neoxey/neox-compact-40m/Navaneeth_Compact_40M_Calculations_BOM_DE.xlsx

Sheet: Parameter_und_Einheiten
Navaneeth Compact 40M v2.0 – Parameter und Einheiten
Verbindliche Master-Parameter, Herstellerspezifikationen, Einheiten und Unsicherheitskennzeichnung
Parameter-ID | Bezeichnung | Symbol | Wert | Einheit | Quelle / Nachweis | Status / Unsicherheit
PAR-01 | Gesamtlänge Flach-Tropfband | L_tape | 40000.00 | mm | Master-Spezifikation / Allwin Gold | VALIDIERT (Feste Anforderung)
PAR-02 | Liegebreite Flach-Tropfband (flach) | W_tape | 25.00 | mm | Allwin Pipes Erode (Toleranz 24,5..25,5 mm) | VALIDIERT (Messung vor Serie)
PAR-03 | Nominaler Innendurchmesser (aufgeblasen) | D_in_tape | 16.00 | mm | Allwin Gold ISI 16 mm Drip Tape | VALIDIERT (Herstellerangabe)
PAR-04 | Effektive Doppelwandstärke inkl. Emitter | t_eff | 1.50 | mm | Einzelwand 0,7 mm + Emitter 2,2..3,0 mm gemittelt | ANNAHME (Physisch zu prüfen)
PAR-05 | Minimaler trockener Biegeradius Band | R_bend_min | 48.00 | mm | Allwin Gold Spezifikation trocken | VALIDIERT (Grenzwert R >= 48 mm)
PAR-06 | Wickel-Packungsfaktor (4-Spur-Traverse) | eta_pack | 0.70 | - | Konservative Annahme inkl. Emitter-Hohlräumen | ANNAHME (Physisch zu prüfen)
PAR-07 | Anzahl axialer Bandspuren auf Trommel | N_lanes | 4.00 | - | 1 durchgehendes 40m-Band über 4 Spuren à 10m | VALIDIERT (REV-06 Traverse)
PAR-08 | Spurabstand / Übergangsstufe | s_lane | 1.00 | mm | Geometriedefinition X = 6,5 + 26*i | VALIDIERT (CAD-Geometrie)
PAR-09 | Nutzbare Konuslänge Trommel | L_cone | 110.00 | mm | X = 3,0 mm bis X = 113,0 mm | VALIDIERT (CAD-Geometrie)
PAR-10 | Hinterer Trommel-Außenradius (X=3) | R_core_back | 52.00 | mm | Ausgangsgeometrie v1.0 / v2.0 | VALIDIERT (CAD-Geometrie)
PAR-11 | Vorderer Trommel-Außenradius (X=113) | R_core_front | 48.15 | mm | Formel R(113) = 52 - 3,85 (> R_bend_min 48,0!) | VALIDIERT (Konflikt aufgelöst)
PAR-12 | Mittlerer Trommel-Kernradius | R_core_mean |  | mm | Berechnet aus R_core_back und R_core_front | VALIDIERT (Formel)
PAR-13 | Flansch-Außendurchmesser | D_flange | 220.00 | mm | Hinter- und Vorderflansch R = 110,0 mm | VALIDIERT (CAD-Geometrie)
PAR-14 | Spindelmittenhöhe über Boden (Z=0) | Z_c | 150.00 | mm | Bezugsebene Y=0, Z=150 mm | VALIDIERT (CAD-Geometrie)
PAR-15 | Bohrschrauber Spannung (INGCO CIDLI12206) | U_drill | 12.00 | V | INGCO Datenblatt CIDLI12206 (12V Li-Ion) | VALIDIERT (Herstellerdaten)
PAR-16 | Leerlaufdrehzahl 1. Gang (INGCO CIDLI12206) | n_drill_low | 400.00 | rpm | INGCO Datenblatt 0-400 / 0-1500 rpm | VALIDIERT (Herstellerdaten)
PAR-17 | Leerlaufdrehzahl 2. Gang (INGCO CIDLI12206) | n_drill_high | 1500.00 | rpm | INGCO Datenblatt 0-400 / 0-1500 rpm | VALIDIERT (Herstellerdaten)
PAR-18 | Max. Katalog-Drehmoment (INGCO CIDLI12206) | M_drill_max | 20.00 | Nm | INGCO Datenblatt 20 Nm (18+1+1 Stufen) | VALIDIERT (Herstellerdaten)
PAR-19 | Ziel-Wickelzeit Minimum | t_wind_min | 3.00 | min | Feste Anforderung Spezifikation | VALIDIERT (Vorgabe)
PAR-20 | Ziel-Wickelzeit Maximum | t_wind_max | 5.00 | min | Feste Anforderung Spezifikation | VALIDIERT (Vorgabe)
PAR-21 | Nominaler Bandzug beim Aufwickeln (trocken) | F_pull_nom | 35.00 | N | Bodenreibung 40 m Flachband auf trockenem Ackerboden | ANNAHME (Zugwaage-Test nötig)
PAR-22 | Max. Bandzug bei Verhaken (Rutschkupplung) | F_pull_max | 120.00 | N | Begrenzt durch Bohrschrauber-Drehmomentstufe 6 (~8 Nm) | ANNAHME (Prüfstandstest nötig)
PAR-23 | Zielmasse Maschine (ohne Schrauber & Akku) | m_target | 5.00 | kg | Feste Anforderung Spezifikation | VALIDIERT (Erreicht: 3,10 kg)

Sheet: Geometrie
Navaneeth Compact 40M v2.0 – Geometrie
Koordinaten-Audit, Trommelkonus-Verifikation und geometrische Konfliktauflösung (v1.0 vs. v2.0)
Geometrie-ID | Baugruppe / Merkmal | Formel / Referenz | Wert v1.0 | Wert v2.0 (Freigegeben) | Differenz | Einheit | Bewertung / Konfliktauflösung
GEO-01 | Trommelbreite berechnet (4 Spuren à 25 mm) |  | 110.00 |  |  | mm | VALIDIERT (100 mm Band + 3 mm Stufen + 7 mm Rand = 110 mm)
GEO-02 | Trommel-Außenradius hinten (X = 3 mm) | R(3) = 52,00 | 52.00 |  |  | mm | VALIDIERT (Unverändert übernommen)
GEO-03 | Trommel-Außenradius vorne (X = 113 mm) | R(113) = 52,0 - 3,85 | 48.15 |  |  | mm | VALIDIERT (48,15 mm > 48,0 mm min. Biegeradius)
GEO-04 | Radialer Konus-Abfall Delta_R (über 110 mm) |  | 3.85 |  |  | mm | VALIDIERT (Lineare Master-Gleichung maßgebend)
GEO-05 | Realer Konuswinkel alpha aus Delta_R = 3,85 mm |  | 2.00 |  |  | Grad | VALIDIERT (Exakt 2,0045°; 2,0° ist Nominalwert)
GEO-06 | Theoretischer Delta_R bei exakt 2,0000° |  | 3.84 |  |  | mm | VALIDIERT (Abweichung nur 0,0087 mm < Fertigungstoleranz)
GEO-07 | Spindeldurchmesser Lagersitz (Lager 6003 d=17) | ISO 286 Welle k5 | 16.80 | 17.00 |  | mm | KONFLIKT GELÖST (v1.0 hatte 0,2 mm Spiel! v2.0: Ø17,00 k5)
GEO-08 | Hinterflansch-Nabenbohrung (REV-03) | ISO 286 H7/h6 + M6-Querstift | 17.80 | 17.02 |  | mm | KONFLIKT GELÖST (v1.0 hatte 1,0 mm Spiel ohne Mitnehmer)
GEO-09 | Lagergehäuse Lagersitzbohrung (Lager 6003 D=35) | ISO 286 Gehäuse H7 | 35.00 | 35.00 |  | mm | VALIDIERT (Mit Innenschulter Ø31 mm bei X=-74..-34 ergänzt)
GEO-10 | Chassisplatte Spindel-Durchgangsbohrung | Freigang für Welle Ø20 / Nabe | 24.00 | 36.00 |  | mm | KONFLIKT GELÖST (Erweitert auf Ø36 mm für Montagefreigang)
GEO-11 | Führungsarm Wandstärke in X (REV-02) | X = -32..-24 mm | 4.00 | 8.00 |  | mm | VALIDIERT (Verdoppelt für Kragarm-Einspannsteifigkeit)
GEO-12 | Führungsachse Durchmesser an Wurzel / Lager (REV-02) | Schulter Ø16 / Lagersitz Ø15,00 k5 | 8.00 | 15.00 |  | mm | KONFLIKT GELÖST (6002-2RS hat d=15,00 mm Bohrung, Schulter Ø16)
GEO-13 | Führungsrolle Außendurchmesser (fuer 6002-2RS D=32) | Lagersitz Ø32 H7 + 3 mm Wand | 24.00 | 38.00 |  | mm | KONFLIKT GELÖST (v1.0 Ø24 war kleiner als Lager 6002 D=32!)
GEO-14 | Fußplatte Unterkante über Boden Z=0 (REV-05) | Z_footplate_min | 6.00 | 12.00 |  | mm | VALIDIERT (Angehoben auf Z=12 mm; Schrauben in +Z gedreht)
GEO-15 | Minimale Bodenfreiheit aller Befestiger (REV-05) | Z_fastener_min | 1.00 | 12.00 |  | mm | VALIDIERT (Keine überstehenden Muttern an Rahmenunterseite)
GEO-16 | Ventilgriff-Stiel Z-Erstreckung (REV-07) | Z = 28..32 mm (R=4 mm) | 30.00 | 28.00 |  | mm | VALIDIERT (2-mm-Lücke zwischen Rohr Z=28 und Stiel geschlossen)

Sheet: Wickelkapazitaet
Navaneeth Compact 40M v2.0 – Wickelkapazitaet
Nachrechnung der 40-m-Wickelkapazität: Einzelspur-Stapel vs. 4-Spur-Traverse und Sensitivitätsanalyse
Szenario-ID | Wickelmodus (Einzelnes durchgehendes 40m-Band) | Spuren N_eff [-] | Eff. Bandstärke t_eff [mm] | Packungsfaktor eta [-] | Berechneter Rollenradius R_coil [mm] | Rollendurchmesser D_coil [mm] | Radialer Flansch-Freiraum (R_flange=110) [mm]
CAP-01 | v2.0 Auslegung: 4-Spur-Traverse (4 x 10 m, nominal R_core=50,0) | 4
CAP-02 | v2.0 Exakt: 4-Spur-Traverse (mittlerer Konus R_core=50,075) | 4
CAP-03 | Sensitivität: 4-Spur-Traverse mit dichter Packung (eta=0,78, t=1,4) | 4 | 1.40 | 0.78
CAP-04 | Sensitivität: 4-Spur-Traverse Worst-Case (eta=0,62, t=1,65) | 4 | 1.65 | 0.62
CAP-05 | Sensitivität: 3-Spur-Traverse (N=3, falls 1 Spur ungenutzt) | 3 | 1.50 | 0.70
CAP-06 | Gegenprobe: 1-Spur-Einzelstapel OHNE Traverse (N=1, t=1,5, eta=0,70) | 1 | 1.50 | 0.70
CAP-07 | Gegenprobe: 1-Spur-Einzelstapel dünnes Band (N=1, t=1,2, eta=0,80) | 1 | 1.20 | 0.80

Sheet: Drehzahl_und_Zeit
Navaneeth Compact 40M v2.0 – Drehzahl und Zeit
Wickelzeit-, Drehzahl- und Untersetzungsmodell mit wachsendem Wickelradius R(N)
Betriebspunkt-ID | Antriebskonfiguration / Szenario | Spindeldrehzahl n_spindel [rpm] | Gesamtumdrehungen N_ges [-] | Berechnete Wickelzeit t_wind [min] | Bandgeschwindigkeit Start v_min [m/s] | Bandgeschwindigkeit Ende v_max [m/s] | Bewertung (Ziel: 3,0 bis 5,0 min)
RPM-01 | Zielzeit Minimum (t = 3,0 min, mit Getriebe i = 12:1 bei 347 rpm) |  |  |  |  |  | FREIGEGEBEN (Untere Zielgrenze 3,0 min)
RPM-02 | Nominaler Auslegungspunkt (t = 4,0 min, mit Getriebe i = 16:1 bei 347 rpm) |  |  |  |  |  | FREIGEGEBEN (Optimaler Betriebspunkt 4,0 min)
RPM-03 | Zielzeit Maximum (t = 5,0 min, mit Getriebe i = 20:1 bei 347 rpm) |  |  |  |  |  | FREIGEGEBEN (Obere Zielgrenze 5,0 min)
RPM-04 | Direktantrieb 1. Gang Teillast-Trigger (n = 60 rpm ohne Getriebe) | 60.00 |  |  |  |  | WARNUNG (1,45 min – zu schnell für Handführung)
RPM-05 | Direktantrieb 1. Gang Nenndrehzahl unter Last (n = 350 rpm) | 350.00 |  |  |  |  | SPERRPUNKT (0,25 min / 15 s – gefährlicher Peitscheffekt!)
RPM-06 | Direktantrieb 1. Gang Leerlauf (INGCO 400 rpm Vollgas) | 400.00 |  |  |  |  | SPERRPUNKT (0,22 min / 13 s – Untersetzung i=16:1 Pflicht!)
RPM-07 | Direktantrieb 2. Gang Leerlauf (INGCO 1500 rpm Vollgas) | 1500.00 |  |  |  |  | SPERRPUNKT (2. Gang mechanisch/organisatorisch sperren!)

Sheet: Drehmoment_und_Kraefte
Navaneeth Compact 40M v2.0 – Drehmoment und Kraefte
Drehmoment-, Bandzug- und Reaktionskraftberechnungen am Spindelantrieb und Bohrschraubergriff
Lastfall-ID | Bezeichnung / Lastzustand | Bandzug F_pull [N] | Wirksamer Hebelarm R [mm] | Spindelmoment M_spindel [Nm] | Reaktionskraft am Griff F_grip (r=85mm) [N] | Zulässiger Grenzwert | Sicherheitsbewertung
TRQ-01 | Wickelbeginn am Kern (Nennbetrieb trocken) |  |  |  |  | 8,00 Nm (Kupplungsstufe 6) | VALIDIERT (M = 1,82 Nm << 8,0 Nm)
TRQ-02 | Wickelende am Außenradius (Nennbetrieb trocken) |  |  |  |  | 8,00 Nm (Kupplungsstufe 6) | VALIDIERT (M = 3,38 Nm << 8,0 Nm)
TRQ-03 | Wickelende feuchtes/verschmutztes Band (Erhöhte Reibung) | 65.0 |  |  |  | 8,00 Nm (Kupplungsstufe 6) | VALIDIERT (M = 6,28 Nm < 8,0 Nm)
TRQ-04 | Blockier-/Verhakungsfall mit Rutschkupplung (Stufe 6) |  |  |  |  | 12,00 Nm (Kupplung löst aus) | VALIDIERT (M = 11,59 Nm; Bandriss > 280 N verhindert)
TRQ-05 | Maximaler Katalog-Blockierfall INGCO CIDLI12206 (REV-04) |  |  |  |  | 20,00 Nm (Struktur-Auslegungslast) | VALIDIERT (Drehmomentstütze P-21 hält 235,3 N sicher)

Sheet: Welle_und_Lager
Navaneeth Compact 40M v2.0 – Welle und Lager
Festigkeitsnachweis Hauptspindel (REV-03), Kragarm-Führungsachse (REV-02) und SKF-Lagerlebensdauer
Nachweis-ID | Bauteil / Querschnitt | Belastungsgröße | Berechneter Wert | Einheit | Zulässiger Wert (Werkstoff / SKF) | Sicherheitsfaktor SF [-] | Status / Kommentar
SHF-01 | Führungsachse v1.0 (Ø8 mm, L=121 mm, F_max=169,7 N) | Biegespannung sigma_b |  | MPa | 430.00 |  | SPERRPUNKT in v1.0 (SF=1,05; Durchbiegung 2,37 mm!)
SHF-02 | Führungsachse v2.0 Lagersitz (Ø15,00 k5, L=121 mm, REV-02) | Biegespannung sigma_b |  | MPa | 430.00 |  | VALIDIERT in v2.0 (SF=6,94; passt zu 6002-2RS d=15!)
SHF-03 | Führungsachse v2.0 Wurzelschulter (Ø16,0 mm bei X=-24, REV-02) | Biegespannung sigma_b |  | MPa | 430.00 |  | VALIDIERT in v2.0 (SF=8,42; Durchbiegung 0,15 mm)
SHF-04 | Hauptspindel v2.0 am Vorderlager X=-29 (Ø17,00 k5, F=141,6 N, T=20 Nm) | Vergleichsspannung sigma_vM |  | MPa | 430.00 |  | VALIDIERT (Kombinierte Biegung + 20 Nm Torsion)
SHF-05 | Hauptspindel v2.0 Nettoquerschnitt an M6-Querbohrung X=-9 (REV-03) | Vergleichsspannung sigma_vM_net | 74.12 | MPa | 430.00 |  | VALIDIERT (Querschnittsschwächung Ø6 in Ø17 berücksichtigt)
SHF-06 | Querschraube M6x35 FK 8.8 bei X=-9 mm (Zweischnittige Scherung) | Scherspannung tau_shear |  | MPa | 384.00 |  | VALIDIERT (Formschnittige Drehmomentübertragung REV-03)
BRG-01 | Vorderes Hauptlager 6003-2RS (X=-34..-24, SKF C0=3250 N) | Max. Radiallast R_front_max |  | N | 3250.00 |  | VALIDIERT (Statische Tragsicherheit S0 = 8,35)
BRG-02 | Hinteres Hauptlager 6003-2RS (X=-84..-74, SKF C0=3250 N) | Max. Radiallast R_rear_max |  | N | 3250.00 |  | VALIDIERT (Statische Tragsicherheit S0 = 13,12)
BRG-03 | Führungsrollenlager 6002-2RS (2x SKF C0=2850 N, REV-02) | Max. Radiallast pro Lager |  | N | 2850.00 |  | VALIDIERT (Statische Tragsicherheit S0 = 19,76)

Sheet: Rahmen_und_Festigkeit
Navaneeth Compact 40M v2.0 – Rahmen und Festigkeit
Festigkeitsnachweis Führungsarm, Chassisplatte, Drehmomentstütze, Flanschschlitze (REV-01) und Kippsicherheit
Struktur-ID | Bauteil / Nachweisstelle | Lastannahme | Berechnete Größe | Einheit | Zulässiger Grenzwert (EN AW-6061-T6) | Sicherheitsfaktor SF [-] | Bewertung
STR-01 | Verstärkter Führungsarm P-12 (B=28, t=8 mm, Hebel 73 mm, REV-02) | Biegespannung am oberen M5-Loch |  | MPa | 240.00 |  | VALIDIERT (Wandstärke 8 mm reduziert Spannung auf 29,3 MPa)
STR-02 | Flansch-Reststeg an 3 Umreifungsschlitzen (REV-01, t=3 mm) | Biegespannung durch Seitenlast 60 N | 24.80 | MPa | 240.00 |  | VALIDIERT (Außenring R=103..110 mm geschlossen ausgeführt)
STR-03 | Konischer Trommelmantel mit 3 Kanälen (t=2,0 mm, REV-01) | Radiale Wickeldruckspannung | 18.40 | MPa | 240.00 |  | VALIDIERT (Beul- und Biegesicherheit SF > 10)
STR-04 | Haupt-Chassisplatte P-11 (t=4,0 mm EN AW-6061-T6) | Biege-/Lochleibungsspannung M5 | 31.50 | MPa | 240.00 |  | VALIDIERT (4x M5 auf Teilkreis R=28 mm tragen Gehäuse sicher)
STR-05 | Bohrschrauber-Drehmomentstütze P-21 (M_max = 20 Nm, REV-04) | Biegespannung U-Profil (W_b = 600 mm³) |  | MPa | 240.00 |  | VALIDIERT (Reaktionsmoment vollständig im Rahmen abgestützt)
STR-06 | Ventilseitige Zugentlastungsklemme P-22 (F_max = 120 N) | Klemmhalte- & Biegespannung | 16.20 | MPa | 240.00 |  | VALIDIERT (Isoliert 100 % der Bandzugkräfte vom Ventil)
STR-07 | Standsicherheit / Kippsicherheit bei Bandzug F_nom = 35 N (Z=285) | Standmoment vs. Kippmoment (mit Fuß auf P-20) | 38.50 | Nm | 9.98 |  | VALIDIERT (Mit Bedienerfuß auf Fußplatte P-20 SF = 3,86)

Sheet: Massenbudget
Navaneeth Compact 40M v2.0 – Massenbudget
Vollständige materialbasierte Massenbilanz (Ziel <= 5,000 kg ohne Bohrschrauber und Akku)
Bauteil-ID | Bezeichnung | Werkstoff | Dichte [g/cm³] | Volumen pro Stück [cm³] | Anzahl [-] | Einzelmasse [kg] | Gesamtmasse [kg]
P-01 | Hinterer Flansch mit angeschweißter Nabe (REV-01/03) | EN AW-6061-T6 | 2.70 | 121.66 | 1
P-02 | Konische Trommel mit 3 Umreifungskanälen (REV-01) | EN AW-6061-T6 | 2.70 | 95.44 | 1
P-03 | Klett-Umreifungsbänder 15x380 mm | PP/PA Gewebeband | 0.91 | 8.55 | 3
P-04 | Vorderer abnehmbarer Schutzflansch mit Bund (REV-01) | EN AW-6061-T6 | 2.70 | 100.03 | 1
P-05 | Axiale Haltescheibe Ø34/Ø17,2x2 mm | C45E verzinkt | 7.85 | 1.35 | 1
P-06 | Sicherungspin Klappstecker Ø6x30 mm mit Zugring | C45E verzinkt | 7.85 | 1.16 | 1
P-07 | Hauptspindel Ø17,00 k5 mit 3/8"-Antriebszapfen (REV-03) | C45E +QT | 7.85 | 50.37 | 1
P-08 | Rillenkugellager 6003-2RS (17x35x10 mm, SKF Katalog) | 100Cr6 Wälzlagerstahl | 7.81 | 4.99 | 2
P-09 | Abgesetztes Lagergehäuse mit Innenschulter (REV-03) | EN AW-6061-T6 | 2.70 | 53.78 | 1
P-10 | Lager-Distanzhülse Innenring Ø22/Ø17,1x40 mm | EN AW-6061-T6 | 2.70 | 6.03 | 1
P-11 | Haupt-Chassisplatte 150x170x4 mm (mit Erleichterungen) | EN AW-6061-T6 | 2.70 | 82.59 | 1
P-12 | Verstärkter Führungsarm 28x95x8 mm (REV-02) | EN AW-6061-T6 | 2.70 | 20.26 | 1
P-13 | Kragarm-Führungsachse Ø16/Ø15,00 k5 hohlgebohrt (REV-02) | C45E +QT | 7.85 | 22.01 | 1
P-14 | Rillenkugellager 6002-2RS (15x32x9 mm, SKF, REV-02) | 100Cr6 Wälzlagerstahl | 7.81 | 3.84 | 2
P-15 | Band-Führungsrolle Ø38x132 mm (REV-02) | POM-C | 1.41 | 74.68 | 1
P-16 | 4-Spur-Bandführungsschlitten X=19/45/71/97 (REV-06) | POM-C | 1.41 | 15.42 | 1
P-17 | Beinleisten 20x82x4 mm (Links & Rechts) | EN AW-6061-T6 | 2.70 | 6.37 | 2
P-18 | Querträger Hohlprofil 20x20x2,5x240 mm | EN AW-6061-T6 | 2.70 | 42.00 | 1
P-19 | Bodenschienen Hohlprofil 20x20x2,5x240 mm (L & R) | EN AW-6061-T6 | 2.70 | 42.00 | 2
P-20 | Fußplatte mit 4 Antirutsch-Rippen Z=12..18 (REV-05) | EN AW-6061-T6 | 2.70 | 46.59 | 1
P-21 | Bohrschrauber-Drehmomentstütze & Griffklemme (REV-04) | EN AW-6061-T6 | 2.70 | 53.59 | 1
P-22 | Ventilseitige Zugentlastungs- und Parkklemme | EN AW-6061-T6 | 2.70 | 16.41 | 1
P-23A | Vordere Elastomerdämpfer-Standfüße Ø24x28 mm | NBR 70 Shore A | 1.25 | 11.88 | 2
P-23B | Hintere Elastomerdämpfer-Pads Ø24x12 mm (REV-05) | NBR 70 Shore A | 1.25 | 5.09 | 4
FAST | Kompletter Normbefestigersatz (34 Verschraubungen F-01..F-34) | Stahl FK 8.8 verzinkt | 7.85 | 23.04 | 1
SUM-M | GESAMTMASSE MASCHINE (ohne Bohrschrauber, Akku & Tropfband) | Zielwert <= 5,000 kg

Sheet: BOM
Navaneeth Compact 40M v2.0 – BOM
Vollständige Stückliste (Revision 2.0) mit Halbzeugen, Fertigungsverfahren, Passungen, Koordinaten und Zeichnungsreferenz
Teile-ID | Bezeichnung | Menge | Werkstoff / Norm | Fertigungsverfahren | Hauptabmessungen [mm] | Bohrungen / Passungen | XYZ-Einbaulage [mm] | Verbundene Teile / Fastener | Gesamtmasse [kg] | Zeichnungs-Nr.
P-01 | Hinterer Flansch mit Nabe | 1 | EN AW-6061-T6 | Laserschneiden + Drehen + WIG-Schweißen | Ø220x3 + Nabe Ø44/Ø17x18 | Nabe Ø17,02 H7, Querloch Ø6,0 H11, 6x Ø5,5, 3x Schlitz 16x58 | X=[-18..3], Y=0, Z=150 | P-02, P-07 / F-11..16, F-21 |  | DRW-P01-v2
P-02 | Konische Trommel (3 Kanäle) | 1 | EN AW-6061-T6 | Drückwalzen / CNC-Drehen + Fräsen | Ø104/Ø96,3 x 110, Wand 2,0 | 6x Ø5,5 auf TK R=38, 3x Kanal B=16xT=6 | X=[3..113], Y=0, Z=150 | P-01, P-03, P-04 / F-11..16 |  | DRW-P02-v2
P-03 | Klett-Umreifungsband | 3 | PP/PA Gewebe | Kaufteil konfektioniert | 15 x 380 x 1,5 | Rückschnallöse Metall/PA | X=[5..111], 0°/120°/240° | P-02, REF-01 (Bandrolle) |  | DRW-P03-v2
P-04 | Vorderer Schutzflansch | 1 | EN AW-6061-T6 | Laserschneiden + CNC-Zentrierbund | Ø220x3 + Bund Ø30x1 | Zentrierbohrung Ø17,20 H8, 6x Ø18, 3x Schlitz 16x58 | X=[113..117], Y=0, Z=150 | P-02, P-05, P-07 |  | DRW-P04-v2
P-05 | Axiale Haltescheibe | 1 | C45E verzinkt | Drehen / Stanzen DIN 988 | Ø34 / Ø17,2 x 2,0 | Bohrung Ø17,20 (+0,20) | X=[117..119], Y=0, Z=150 | P-04, P-06, P-07 |  | DRW-P05-v2
P-06 | Sicherungspin (Klappstecker) | 1 | Stahl verzinkt | Normkaufteil DIN 11023 | Schaft Ø6,0 x 30, Ring Ø17 | Paarung mit Bohrung Ø6,2 in P-07 | X=122, Y=0, Z=[135..175] | P-05, P-07 |  | DRW-P06-v2
P-07 | Hauptspindel mit 3/8"-Sechskant | 1 | C45E +QT | CNC-Drehen + Fräsen + Schleifen | Ø17,00 k5 x 212 + SW9,5 x 36 | Lagersitz Ø17,00 k5, Schulter Ø20, Querloch Ø6,0 (X=-9), Pinloch Ø6,2 (X=122) | X=[-120..128], Y=0, Z=150 | P-01, P-04..06, P-08, P-10 / F-21 |  | DRW-P07-v2
P-08 | Rillenkugellager 6003-2RS | 2 | 100Cr6 (SKF) | Normkaufteil DIN 625-1 | d=17,00 x D=35,00 x B=10,00 | Innenring auf Ø17 k5, Außenring in Ø35 H7 | X=[-84..-74] & [-34..-24], Z=150 | P-07, P-09, P-10 |  | DRW-P08-v2
P-09 | Abgesetztes Lagergehäuse | 1 | EN AW-6061-T6 | CNC-Drehen + Bohren | Rohr Ø45x56, Flansch Ø68x4 | 2x Lagersitz Ø35,00 H7 (10 tief), Innenschulter Ø31, 4x Ø5,5 auf TK R=28 | X=[-84..-24], Y=0, Z=150 | P-08, P-11 / F-01..04 |  | DRW-P09-v2
P-10 | Lager-Distanzhülse Innenring | 1 | EN AW-6061-T6 | Drehen aus Rohr | Ø22,0 / Ø17,1 x 40,0 | Bohrung Ø17,10 (+0,10), Planlauf 0,02 | X=[-74..-34], Y=0, Z=150 | P-07, P-08A, P-08B |  | DRW-P10-v2
P-11 | Haupt-Chassisplatte | 1 | EN AW-6061-T6 | Laserschneiden + Entgraten | 150 x 170 x 4,0 | Zentral Ø36, 4x Ø5,5 (TK28), 4x Ø5,5 (Beine), 2x Ø5,5 (Arm), 2x Fenster 30x70 | X=[-24..-20], Y=[-75..75], Z=[65..235] | P-09, P-12, P-17 / F-01..10 |  | DRW-P11-v2
P-12 | Verstärkter Führungsarm | 1 | EN AW-6061-T6 | CNC-Fräsen / Wasserstrahl | 28 x 95 x 8,0 | 2x Ø5,5 (Z=212, 228), 1x Ø10,2 (Z=285) | X=[-32..-24], Y=[-14..14], Z=[205..300] | P-11, P-13 / F-09..10, F-22 |  | DRW-P12-v2
P-13 | Kragarm-Führungsachse | 1 | C45E +QT | CNC-Drehen + Tieflochbohren | M10x12 + Ø16x10 + Ø15,00 k5 x 142 | Lagersitz Ø15,00 k5, Hohlbohrung Ø8x120, Gewinde M10x1,5 | X=[-36..128], Y=0, Z=285 | P-12, P-14 / F-22 |  | DRW-P13-v2
P-14 | Rillenkugellager 6002-2RS | 2 | 100Cr6 (SKF) | Normkaufteil DIN 625-1 | d=15,00 x D=32,00 x B=9,00 | Innenring auf Ø15 k5, Außenring in Ø32 H7 | X=[-14..-5] & [109..118], Z=285 | P-13, P-15 |  | DRW-P14-v2
P-15 | Band-Führungsrolle | 1 | POM-C | CNC-Drehen | Ø38,0 / Ø26,0 x 132,0 | 2x Lagersitz Ø32,00 H7 x 9,0 tief | X=[-14..118], Y=0, Z=285 | P-14, P-16 |  | DRW-P15-v2
P-16 | 4-Spur-Bandführungsschlitten | 1 | POM-C | CNC-Fräsen / Drehen | 5x Führungsbund Ø47/Ø38 x 2,0 | Spurzentren X=19, 45, 71, 97 mm (Spurbreite 26 mm) | X=[4,5..110,5], Y=0, Z=285 | P-15, REF-01 |  | DRW-P16-v2
P-17 | Beinleisten (Links & Rechts) | 2 | EN AW-6061-T6 | Laserschneiden + Schweißen an P-18 | 20 x 82 x 4,0 | Je 2x Ø5,5 bei Z=75 und Z=100 mm | X=[-28..-24], Y=±[45..65], Z=[28..110] | P-11, P-18 / F-05..08 |  | DRW-P17-v2
P-18 | Querträger Hohlprofil | 1 | EN AW-6061-T6 | Sägen + Bohren + Senken | 20 x 20 x 2,5 x 240 | 2x Ø6,5 (Y=±95), 2x Ø6,5 (Y=±30), Flachsenkung unten Z=8..12 | X=[-34..-14], Y=[-120..120], Z=[8..28] | P-17, P-19, P-20, P-23B / F-17..20 |  | DRW-P18-v2
P-19 | Bodenschienen Hohlprofil (L&R) | 2 | EN AW-6061-T6 | Sägen + Bohren | 20 x 20 x 2,5 x 240 | Je 1x Ø6,5 (X=-24), 1x Ø5,5 (X=196), 2x Ø5,5 (Zugentlastung) | X=[-34..206], Y=±[85..105], Z=[28..48] | P-18, P-22, P-23A / F-17..18, F-27..30 |  | DRW-P19-v2
P-20 | Fußplatte mit Antirutsch-Rippen | 1 | EN AW-6061-T6 | Fräsen / Strangpressprofil | 140 x 100 x 3,0 + 4 Rippen 4x3 | 2x Ø6,5 (X=-24, Y=±30), 4x Ø5,5 (Drehmomentstütze), 2x Ø5,5 (Pads) | X=[-154..-14], Y=[-50..50], Z=[12..18] | P-18, P-21, P-23B / F-19..20, F-23..26 |  | DRW-P20-v2
P-21 | Bohrschrauber-Drehmomentstütze | 1 | EN AW-6061-T6 + NBR | Abkanten + Fräsen + NBR-Auskleidung | 60 x 60 x 93, Griffaufnahme 45x36 | 4x Ø5,5 Fußflansch, 2x M5 Klemmschraube für Griff | X=[-235..-175], Y=[-30..30], Z=[15..108] | P-20, REF-02 / F-23..26 |  | DRW-P21-v2
P-22 | Ventil-Zugentlastungsklemme | 1 | EN AW-6061-T6 + POM | CNC-Fräsen | 32 x 30 x 36, Bandkanal 26x4 | 2x Ø5,5 Montage an rechter Bodenschiene + Schnellspanner | X=[42..74], Y=[-135..-105], Z=[28..64] | P-19R, REF-03 / F-27..28 |  | DRW-P22-v2
P-23A | Vordere Elastomerdämpfer-Füße | 2 | NBR 70 Shore A | Kaufteil / Formteil | Ø24 / Ø6,0 x 28,0 | Durchgangsbohrung Ø5,5 mit Senkung | X=196, Y=±95, Z=[0..28] | P-19 / F-29..30 |  | DRW-P23-v2
P-23B | Hintere Elastomerdämpfer-Pads | 4 | NBR 70 Shore A | Kaufteil / Formteil | Ø24 / Ø5,5 x 12,0 | Durchgangsbohrung Ø5,5 mit Senkung | X=-24 (Y=±110) & X=-140 (Y=±40), Z=[0..12] | P-18, P-20 / F-31..34 |  | DRW-P23-v2

Sheet: Fastener_Register
Navaneeth Compact 40M v2.0 – Fastener Register
Vollständiges Befestigerregister mit Instanz-ID, Norm, Gewinde, XYZ-Position, Einbaurichtung und Montagezugang
Fastener-ID | Norm & Gewinde | Abmessung & Kopfform | Scheiben & Mutter | Werkstoff / Klasse | XYZ-Mittelpunkt [mm] | Achs- & Einbaurichtung | Verbundene Bauteile | Montagezugang / Werkzeug | Richt-Anziehdrehmoment [Nm]
F-01 | ISO 4017 M5x16 | M5 x 16, Sechskant SW8 | 2x ISO 7089 A5,3 + 1x ISO 10511 M5 | Stahl FK 8.8 verzinkt | X=-28..-16, Y=+19,8, Z=169,8 (45°) | +X (Kopf bei X=-28, Mutter X=-20) | P-09 (Lagergehäuse) + P-11 (Chassis) | SW8 Steckschlüssel beidseitig frei | 5.5
F-02 | ISO 4017 M5x16 | M5 x 16, Sechskant SW8 | 2x ISO 7089 A5,3 + 1x ISO 10511 M5 | Stahl FK 8.8 verzinkt | X=-28..-16, Y=-19,8, Z=169,8 (135°) | +X (Kopf bei X=-28, Mutter X=-20) | P-09 (Lagergehäuse) + P-11 (Chassis) | SW8 Steckschlüssel beidseitig frei | 5.5
F-03 | ISO 4017 M5x16 | M5 x 16, Sechskant SW8 | 2x ISO 7089 A5,3 + 1x ISO 10511 M5 | Stahl FK 8.8 verzinkt | X=-28..-16, Y=-19,8, Z=130,2 (225°) | +X (Kopf bei X=-28, Mutter X=-20) | P-09 (Lagergehäuse) + P-11 (Chassis) | SW8 Steckschlüssel beidseitig frei | 5.5
F-04 | ISO 4017 M5x16 | M5 x 16, Sechskant SW8 | 2x ISO 7089 A5,3 + 1x ISO 10511 M5 | Stahl FK 8.8 verzinkt | X=-28..-16, Y=+19,8, Z=130,2 (315°) | +X (Kopf bei X=-28, Mutter X=-20) | P-09 (Lagergehäuse) + P-11 (Chassis) | SW8 Steckschlüssel beidseitig frei | 5.5
F-05 | ISO 4017 M5x16 | M5 x 16, Sechskant SW8 | 2x ISO 7089 A5,3 + 1x ISO 10511 M5 | Stahl FK 8.8 verzinkt | X=-28..-16, Y=+55,0, Z=75,0 | +X (Kopf bei X=-28, Mutter X=-20) | P-17L (Bein links) + P-11 (Chassis) | SW8 Gabel-/Ringmaulschlüssel frei | 5.5
F-06 | ISO 4017 M5x16 | M5 x 16, Sechskant SW8 | 2x ISO 7089 A5,3 + 1x ISO 10511 M5 | Stahl FK 8.8 verzinkt | X=-28..-16, Y=+55,0, Z=100,0 | +X (Kopf bei X=-28, Mutter X=-20) | P-17L (Bein links) + P-11 (Chassis) | SW8 Gabel-/Ringmaulschlüssel frei | 5.5
F-07 | ISO 4017 M5x16 | M5 x 16, Sechskant SW8 | 2x ISO 7089 A5,3 + 1x ISO 10511 M5 | Stahl FK 8.8 verzinkt | X=-28..-16, Y=-55,0, Z=75,0 | +X (Kopf bei X=-28, Mutter X=-20) | P-17R (Bein rechts) + P-11 (Chassis) | SW8 Gabel-/Ringmaulschlüssel frei | 5.5
F-08 | ISO 4017 M5x16 | M5 x 16, Sechskant SW8 | 2x ISO 7089 A5,3 + 1x ISO 10511 M5 | Stahl FK 8.8 verzinkt | X=-28..-16, Y=-55,0, Z=100,0 | +X (Kopf bei X=-28, Mutter X=-20) | P-17R (Bein rechts) + P-11 (Chassis) | SW8 Gabel-/Ringmaulschlüssel frei | 5.5
F-09 | ISO 4017 M5x20 | M5 x 20, Sechskant SW8 | 2x ISO 7089 A5,3 + 1x ISO 10511 M5 | Stahl FK 8.8 verzinkt | X=-32..-16, Y=0,0, Z=212,0 | +X (Kopf bei X=-32, Mutter X=-20) | P-12 (Führungsarm 8mm) + P-11 (Chassis) | SW8 vor Flanschmontage voll zugänglich | 5.5
F-10 | ISO 4017 M5x20 | M5 x 20, Sechskant SW8 | 2x ISO 7089 A5,3 + 1x ISO 10511 M5 | Stahl FK 8.8 verzinkt | X=-32..-16, Y=0,0, Z=228,0 | +X (Kopf bei X=-32, Mutter X=-20) | P-12 (Führungsarm 8mm) + P-11 (Chassis) | SW8 vor Flanschmontage voll zugänglich | 5.5
F-11 | ISO 4017 M5x12 | M5 x 12, Sechskant SW8 | 2x ISO 7089 A5,3 + 1x ISO 10511 M5 | Stahl FK 8.8 verzinkt | X=0..10, Y=+32,9, Z=169,0 (30°) | +X (Kopf bei X=0, Mutter im Konus X=6) | P-01 (Hinterflansch) + P-02 (Trommel) | SW8 durch offenes Trommelende +X | 5.5
F-12 | ISO 4017 M5x12 | M5 x 12, Sechskant SW8 | 2x ISO 7089 A5,3 + 1x ISO 10511 M5 | Stahl FK 8.8 verzinkt | X=0..10, Y=0,0, Z=188,0 (90°) | +X (Kopf bei X=0, Mutter im Konus X=6) | P-01 (Hinterflansch) + P-02 (Trommel) | SW8 durch offenes Trommelende +X | 5.5
F-13 | ISO 4017 M5x12 | M5 x 12, Sechskant SW8 | 2x ISO 7089 A5,3 + 1x ISO 10511 M5 | Stahl FK 8.8 verzinkt | X=0..10, Y=-32,9, Z=169,0 (150°) | +X (Kopf bei X=0, Mutter im Konus X=6) | P-01 (Hinterflansch) + P-02 (Trommel) | SW8 durch offenes Trommelende +X | 5.5
F-14 | ISO 4017 M5x12 | M5 x 12, Sechskant SW8 | 2x ISO 7089 A5,3 + 1x ISO 10511 M5 | Stahl FK 8.8 verzinkt | X=0..10, Y=-32,9, Z=131,0 (210°) | +X (Kopf bei X=0, Mutter im Konus X=6) | P-01 (Hinterflansch) + P-02 (Trommel) | SW8 durch offenes Trommelende +X | 5.5
F-15 | ISO 4017 M5x12 | M5 x 12, Sechskant SW8 | 2x ISO 7089 A5,3 + 1x ISO 10511 M5 | Stahl FK 8.8 verzinkt | X=0..10, Y=0,0, Z=112,0 (270°) | +X (Kopf bei X=0, Mutter im Konus X=6) | P-01 (Hinterflansch) + P-02 (Trommel) | SW8 durch offenes Trommelende +X | 5.5
F-16 | ISO 4017 M5x12 | M5 x 12, Sechskant SW8 | 2x ISO 7089 A5,3 + 1x ISO 10511 M5 | Stahl FK 8.8 verzinkt | X=0..10, Y=+32,9, Z=131,0 (330°) | +X (Kopf bei X=0, Mutter im Konus X=6) | P-01 (Hinterflansch) + P-02 (Trommel) | SW8 durch offenes Trommelende +X | 5.5
F-17 | ISO 4762 M6x45 | M6 x 45, Zylinderschraube ISK5 | 2x ISO 7089 A6,4 + 1x ISO 10511 M6 | Stahl FK 8.8 verzinkt | X=-24,0, Y=+95,0, Z=12..53 (REV-05) | +Z (Kopf versenkt Z=8..12, Mutter Z=48) | P-18 (Querträger) + P-19L (Schiene L) | ISK5 unten + SW10 oben (12mm Bodenfreiheit!) | 9.5
F-18 | ISO 4762 M6x45 | M6 x 45, Zylinderschraube ISK5 | 2x ISO 7089 A6,4 + 1x ISO 10511 M6 | Stahl FK 8.8 verzinkt | X=-24,0, Y=-95,0, Z=12..53 (REV-05) | +Z (Kopf versenkt Z=8..12, Mutter Z=48) | P-18 (Querträger) + P-19R (Schiene R) | ISK5 unten + SW10 oben (12mm Bodenfreiheit!) | 9.5
F-19 | ISO 7380 M6x25 | M6 x 25, Flachkopf ISK4 | 2x ISO 7089 A6,4 + 1x ISO 10511 M6 | Stahl FK 8.8 verzinkt | X=-24,0, Y=+30,0, Z=12..33 (REV-05) | +Z (Kopf bei Z=12, Mutter oben Z=28) | P-18 (Querträger) + P-20 (Fußplatte) | ISK4 unten (Z=12) + SW10 oben (Z=28) | 9.5
F-20 | ISO 7380 M6x25 | M6 x 25, Flachkopf ISK4 | 2x ISO 7089 A6,4 + 1x ISO 10511 M6 | Stahl FK 8.8 verzinkt | X=-24,0, Y=-30,0, Z=12..33 (REV-05) | +Z (Kopf bei Z=12, Mutter oben Z=28) | P-18 (Querträger) + P-20 (Fußplatte) | ISK4 unten (Z=12) + SW10 oben (Z=28) | 9.5
F-21 | ISO 4762 M6x50 | M6 x 50, Paß-/Querschraube ISK5 | 2x ISO 7089 A6,4 + 1x ISO 10511 M6 | Stahl FK 8.8 verzinkt | X=-9,0, Y=-25..+25, Z=150,0 (REV-03) | +Y (Quer durch Nabe Ø44 und Welle Ø17) | P-01 (Hinterflansch-Nabe) + P-07 (Spindel) | ISK5 + SW10 radial zwischen X=-18..0 frei | 10.0
F-22 | ISO 10511 M10x1,5 | M10x1,5 Sicherungsmutter SW17 | 1x ISO 7089 A10,5 Scheibe | Stahl FK 8 verzinkt | X=-36..-32, Y=0,0, Z=285,0 (REV-02) | -X (Auf Gewindezapfen von P-13) | P-13 (Führungsachse) + P-12 (Führungsarm) | SW17 Ringschlüssel auf Rückseite X=-36 | 35.0
F-23..26 | 4x ISO 7380 M5x16 | 4x M5 x 16, Flachkopf ISK3 | 8x ISO 7089 A5,3 + 4x ISO 10511 M5 | Stahl FK 8.8 verzinkt | X=-225..-185, Y=±24, Z=12..24 (REV-04) | +Z (Von Fußplatte Z=12 nach oben) | P-21 (Drehmomentstütze) + P-20 (Fußplatte) | ISK3 + SW8 frei zugänglich | 5.5
F-27..28 | 2x ISO 4762 M5x16 | 2x M5 x 16, Zylinderschraube ISK4 | 4x ISO 7089 A5,3 + 2x ISO 10511 M5 | Stahl FK 8.8 verzinkt | X=48 & 68, Y=-105, Z=38,0 | -Y (An rechter Bodenschiene P-19R) | P-22 (Ventil-Zugentlastung) + P-19R | ISK4 seitlich frei zugänglich | 5.5
F-29..34 | 6x ISO 4762 M5x16 | 6x M5 x 16, Senksitz in Gummifuß | 6x ISO 7089 A5,3 + 6x Einpressmutter M5 | Edelstahl A2-70 | X=196 (Y=±95), X=-24 (Y=±110), X=-140 (Y=±40) | +Z (Tief im Gummifuß versenkt Z>=8) | P-23A/B (Elastomerfüße) + P-18/P-19/P-20 | ISK4 von unten durch Senkung im Gummifuß | 4.0

Sheet: Verbindungen
Navaneeth Compact 40M v2.0 – Verbindungen
Vollständiges Verbindungs- und Passungsregister (Mating-Flächen, Passungen, Befestiger und Prüfmethoden)
Verbindungs-ID | Bauteil A | Bauteil B | Verbindungstyp | Mating-Flächen & Achse | Maße, Passung & Spiel | Befestiger-IDs | Montagereihenfolge | Prüfmethode
JNT-01 | P-07 (Spindel) | P-08A/B (Lager 6003) | Zylindrische Wälzlagerpassung | X=[-84..-74] & [-34..-24], Koaxial X | Welle Ø17,00 k5 (+2/+10 µm) in Lager d=17,00 | P-10 (Distanzhülse) | Schritt 1 (Baugruppe Spindel) | Bügelmessschraube Ø17,002..17,010 mm
JNT-02 | P-08A/B (Lager 6003) | P-09 (Lagergehäuse) | Abgesetzter Lagersitz mit Schulter | X=[-84..-74] & [-34..-24], Schulter X=-74/-34 | Gehäuse Ø35,00 H7 (+0/+25 µm) für D=35,00 | Gehäuseschulter Ø31 | Schritt 2 (Einpressen in Gehäuse) | Grenzlehrdorn Ø35 H7 + Tiefenmaß 10,0 mm
JNT-03 | P-09 (Lagergehäuse) | P-11 (Chassisplatte) | Stirnflansch-Verschraubung | Ebene X = -24,0 mm, Teilkreis R=28 mm | 4x Ø5,5 Durchgangsloch, Zentrierung über Ø36 | F-01, F-02, F-03, F-04 | Schritt 5 (Nach Rahmenmontage) | Drehmomentschlüssel 5,5 Nm + Rundlaufprüfung
JNT-04 | P-01 (Hinterflansch-Nabe) | P-07 (Spindel) | Formschnittige Naben-Stift-Verbindung (REV-03) | X=[-18..3], Querbohrung X=-9,0 mm | Nabe Ø17,02 H7 auf Ø17,00 k5 + Querbolzen Ø6 | F-21 (M6x50 FK 8.8) | Schritt 6 (Trommel-Aufschub) | Drehmomenttest 20 Nm spielfrei
JNT-05 | P-01 (Hinterflansch) | P-02 (Konische Trommel) | Axiale Flanschverschraubung | Ebene X = 3,0 mm, Teilkreis R=38 mm | 6x Ø5,5 Bohrung auf TK Ø76 mm | F-11, F-12, F-13, F-14, F-15, F-16 | Schritt 3 (Vormontage Trommel) | Planlaufprüfung Flansch < 0,15 mm
JNT-06 | P-04 (Vorderflansch) | P-02 (Trommel) & P-07 | Schnellwechsel-Steckpassung (+X) | Ebene X = 113,0 mm, Spindel X=[113..117] | Zentrierbohrung Ø17,20 H8 auf Welle Ø17,00 (Spiel +0,2) | P-05 (Scheibe) + P-06 (Pin) | Schritt 7 (Schnellverschluss) | Abziehbarkeit von Hand in +X ohne Verkanten
JNT-07 | P-12 (Führungsarm 8mm) | P-11 (Chassisplatte) | Doppel-Scherverschraubung (REV-02) | Ebene X = -24,0 mm, Z=212 & 228 mm | 2x Ø5,5 Durchgangsbohrung, Plananlage 28x30 mm | F-09, F-10 | Schritt 4 (Vor Hinterflansch) | Winkligkeit Führungsachse zu Spindel < 0,2°
JNT-08 | P-13 (Führungsachse) | P-12 (Führungsarm) & P-14 | Schulterbolzen + Lagersitz (REV-02) | Schulter X=-24, Lagersitze X=[-14..-5] & [109..118] | Wurzel Ø16 am Arm, Lagersitz Ø15,00 k5 für 6002-2RS | F-22 (M10x1,5 Mutter) | Schritt 8 (Führungsbaugruppe) | Grenzrachenlehre Ø15 k5 + Leichtlauf Rolle
JNT-09 | P-18 (Querträger) | P-19L/R & P-20 (Fußplatte) | Bodenfreie Rahmenverschraubung (+Z, REV-05) | Ebenen Z = 28,0 mm und Z = 12,0 mm | Köpfe bei Z=8..12 versenkt, Muttern oben Z=28/48 | F-17, F-18, F-19, F-20 | Schritt 1 (Grundrahmen) | Bodenfreiheitslehre >= 12,0 mm unter allen Schrauben
JNT-10 | P-21 (Drehmomentstütze) | P-20 (Fußplatte) & REF-02 | Formschlüssige Griff-Reaktionsstütze (REV-04) | Z=15,0 mm (Fußplatte) & Z=[78..102] (Griff) | Griffaufnahme 45x36 mm mit 3mm NBR-Schutzpolster | F-23, F-24, F-25, F-26 | Schritt 9 (Schrauber-Einsetzen) | Blockiermoment-Test 20 Nm ohne Gehäusedrehung
JNT-11 | P-22 (Zugentlastung) | P-19R (Schiene R) & REF-03 | Klemmende Band-Zugentlastung | X=[42..74], Y=-105..-135, Z=[28..64] | Bandkanal 26x4 mm klemmt Band vor Ventilanschluss | F-27, F-28 | Schritt 10 (Feldanschluss) | Zugtest 120 N am Band -> 0 N am Ventilanschluss

Sheet: Validierung_und_Risiken
Navaneeth Compact 40M v2.0 – Validierung und Risiken
Trennungsnachweis (Annahme vs. Berechnung vs. CAD-Prüfung vs. Physischer Test) und Freigabesperrpunkte
Risiko-/Prüf-ID | Thema / Anforderung | Kategorie | Durchgeführte Prüfung in v2.0 | Ergebnis / Zahlenwert | Noch erforderlicher physischer Test | Auswirkung auf Serienfreigabe | Status
VAL-01 | Wickelkapazität 40 m Einzelband (4-Spur-Traverse) | Berechnung + CAD | Kreisringmodell über 4 Spuren à 10 m + 3D-Geometrie | R_coil = 96,58 mm < R_flange = 110 mm (13,4 mm Reserve) | Wickelversuch mit realem 40m ALLWIN GOLD Band (t_eff, eta) | Freigegeben für Prototypenbau | VALIDIERT (CAD & Rechnung)
VAL-02 | Lager-/Wellenpassungen 6003-2RS & 6002-2RS (REV-02/03) | Herstellerdaten + CAD | Abgleich mit SKF-Katalog (6003 d=17/D=35; 6002 d=15/D=32) | Welle Ø17,00 k5 / Ø15,00 k5, Gehäuse Ø35 H7 / Ø32 H7 | Passungsmessung nach CNC-Fertigung | Konflikt aus v1.0 vollständig behoben | FREIGEGEBEN (ISO-Passung)
VAL-03 | Biegefestigkeit Kragarm-Führungsachse (REV-02) | Berechnung + CAD | Biegenachweis C45E bei F_max = 169,7 N an Spur 4 (X=97) | sigma_max = 62,0 MPa (SF = 6,94), f_max = 0,19 mm | Belastungstest mit 15 kg Prüflast am Rollenende | Konflikt aus v1.0 (SF=1,05) behoben | VALIDIERT (CAD & Rechnung)
VAL-04 | Drehmomentübertragung Spindel-Nabe (REV-03) | Berechnung + CAD | Nachweis M6-Querschraube FK 8.8 bei X=-9 mm unter 20 Nm | tau_shear = 41,6 MPa (SF = 9,23), sigma_vM_net = 74,1 MPa | Dauerlasttest 500 Wickelzyklen unter Kupplungsauslösung | Formschnittige Mitnahme nachgewiesen | VALIDIERT (CAD & Rechnung)
VAL-05 | Reaktionsmoment-Abstützung Bohrschrauber (REV-04) | Berechnung + CAD | Konstruktion Stützbock P-21 für 20 Nm (F_grip = 235,3 N) | sigma_b = 29,4 MPa (SF = 8,16), Trigger & Akku frei | Ergonomie- und Einspanntest mit realem INGCO CIDLI12206 | Physisches Ausmessen des CIDLI12206-Gehäuses vor Fräsen | BEDINGT (Geometrieabgleich Schrauber)
VAL-06 | Bodenfreiheit aller Befestiger >= 12 mm (REV-05) | CAD-Kollisionsprüfung | Fußplatte auf Z=12..18 angehoben, M6-Schrauben in +Z gedreht | Min. Schraubenkopfhöhe Z = 8..12 mm versenkt, 0 mm Überstand | Sichtprüfung am montierten Rahmen | Vollständig gelöst | FREIGEGEBEN (CAD-geprüft)
VAL-07 | Umreifung & axiale Rollenentnahme in +X (REV-01) | CAD-Kinematikprüfung | 3 Schlitze 16x58 mm in P-01/P-04 + 3 Kanäle 16x6 in P-02 | 2,0°-Konus gibt nach 5 mm Abzug 0,17 mm radiales Spiel frei | Abziehkraftmessung einer stramm gewickelten 40m-Rolle | Konstruktiver Pfad frei nachgewiesen | VALIDIERT (Physischer Abziehtest offen)
RISK-01 | Kinematik: Stationärer Ventilanschluss beim Wickeln | Kinematische Analyse | Drehende Trommel (86,8 Umdr.) vs. festes Ventil bei Y=-262 mm | Festes Ventilende darf sich NICHT 86,8x mitdrehen! | Feldprozess festlegen: Wickeln vom freien Feldende zum Ventil + Parken in Klemme P-22 | SPERRPUNKT falls Wickeln vom Ventilende ohne Drehdurchführung gefordert! | OFFEN (Betriebsmodus bestätigen)
RISK-02 | Drehzahlreduzierung für 3–5 min Wickelzeit | Antriebsrechnung | 86,8 Umdr. in 4 min erfordert 21,7 rpm; Schrauber hat 0–400 rpm | Direktantrieb bei 400 rpm wickelt in 13 s (18x zu schnell!) | Vorsatz-Planetengetriebe i=16:1 (3/8"-Aufnahme) oder Drehzahlbegrenzer testen | SPERRPUNKT für Serienfreigabe ohne Untersetzung i=12..16:1 | OFFEN (Getriebestufe ergänzen)
