neoxey/neox-compact-40m/CAD/STL/Navaneeth_Compact_40M_v2_Complete_Assembly.stl

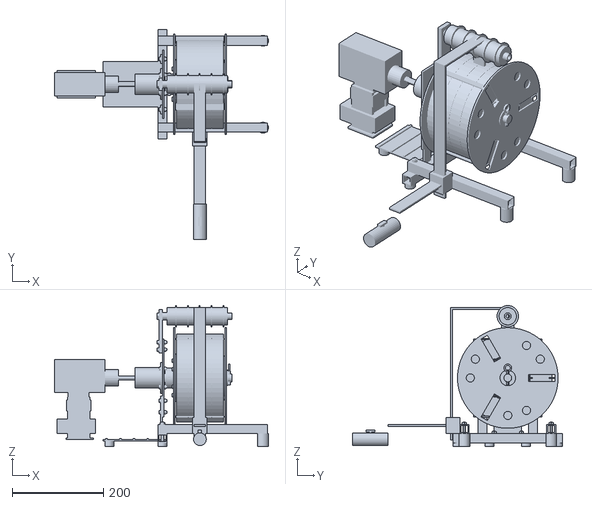
[picture p28: CAD file, 2026-10-24]
CAD/STL/Navaneeth_Compact_40M_v2_Complete_Assembly.stl
468.0 x 460.0 x 308.5
