neoxey/neox-compact-40m/(list of files, cad)

Other CAD files:
CAD/STEP/Navaneeth_Compact_40M_v2_Assembly.step
CAD/STEP/parts/P-07_Hauptspindel_d=17,00_k5.step
CAD/STEP/parts/P-21_Bohrschrauber-Drehmomentstuetze.step
CAD/STEP/parts/P-17_Beinleisten_Links_&_Rechts.step
CAD/STEP/parts/REF-02_INGCO_CIDLI12206_12V_Bohrschrauber.step
CAD/STEP/parts/P-15_Band-Fuehrungsrolle_d=38mm.step
CAD/STEP/parts/P-14_Rillenkugellager_6002-2RS.step
CAD/STEP/parts/P-03_Klett-Umreifungsbaender.step
CAD/STEP/parts/P-20_Fussplatte_Z=12..18.step
CAD/STEP/parts/P-12_Verstaerkter_Fuehrungsarm_8mm.step
CAD/STEP/parts/P-09_Abgesetztes_Lagergehaeuse.step
CAD/STEP/parts/P-16_4-Spur-Bandfuehrungsschlitten.step
CAD/STEP/parts/P-19_Bodenschienen_Links_&_Rechts.step
CAD/STEP/parts/P-06_Sicherungspin_mit_Zugring.step
CAD/STEP/parts/P-13_Kragarm-Fuehrungsachse_d=16_15mm.step
CAD/STEP/parts/P-08_Rillenkugellager_6003-2RS.step
CAD/STEP/parts/P-04_Vorderer_Schutzflansch.step
CAD/STEP/parts/REF-01_40m_ALLWIN_GOLD_Tropfband-Rolle.step
CAD/STEP/parts/REF-03_Stationaerer_Ventilanschluss_&_Bandpfad.step
CAD/STEP/parts/P-22_Ventil-Zugentlastungsklemme.step
CAD/STEP/parts/P-11_Haupt-Chassisplatte.step
CAD/STEP/parts/P-02_Konische_Trommel_mit_Umreifungskanaelen.step
CAD/STEP/parts/P-10_Lager-Distanzhuelse.step
CAD/STEP/parts/P-18_Quertraeger_Hohlprofil_20x20.step
CAD/STEP/parts/P-23_Elastomer-Standfuesse_&_Pads.step
CAD/STEP/parts/FAST_Normbefestigersatz.step
CAD/STEP/parts/P-05_Axiale_Haltescheibe.step
CAD/STEP/parts/P-01_Hinterer_Flansch_mit_Nabe.step
CAD/STL/FAST_Normbefestigersatz.stl
CAD/STL/P-01_Hinterer_Flansch_mit_Nabe.stl
CAD/STL/P-02_Konische_Trommel_mit_Umreifungskanaelen.stl
CAD/STL/P-03_Klett-Umreifungsbaender.stl
CAD/STL/P-04_Vorderer_Schutzflansch.stl
CAD/STL/P-05_Axiale_Haltescheibe.stl
CAD/STL/P-06_Sicherungspin_mit_Zugring.stl
CAD/STL/P-07_Hauptspindel_d=17,00_k5.stl
CAD/STL/P-08_Rillenkugellager_6003-2RS.stl
CAD/STL/P-09_Abgesetztes_Lagergehaeuse.stl
CAD/STL/P-10_Lager-Distanzhuelse.stl
CAD/STL/P-11_Haupt-Chassisplatte.stl
CAD/STL/P-12_Verstaerkter_Fuehrungsarm_8mm.stl
CAD/STL/P-13_Kragarm-Fuehrungsachse_d=16_15mm.stl
CAD/STL/P-14_Rillenkugellager_6002-2RS.stl
CAD/STL/P-15_Band-Fuehrungsrolle_d=38mm.stl
CAD/STL/P-16_4-Spur-Bandfuehrungsschlitten.stl
CAD/STL/P-17_Beinleisten_Links_&_Rechts.stl
CAD/STL/P-18_Quertraeger_Hohlprofil_20x20.stl
CAD/STL/P-19_Bodenschienen_Links_&_Rechts.stl
CAD/STL/P-20_Fussplatte_Z=12..18.stl
CAD/STL/P-21_Bohrschrauber-Drehmomentstuetze.stl
CAD/STL/P-22_Ventil-Zugentlastungsklemme.stl
CAD/STL/P-23_Elastomer-Standfuesse_&_Pads.stl
CAD/STL/REF-01_40m_ALLWIN_GOLD_Tropfband-Rolle.stl
CAD/STL/REF-02_INGCO_CIDLI12206_12V_Bohrschrauber.stl
CAD/STL/REF-03_Stationaerer_Ventilanschluss_&_Bandpfad.stl
