neoxey/neox-compact-40m/Drawings/Navaneeth_Compact_40M_v2_Technical_Drawings_DE.pdf

200

250

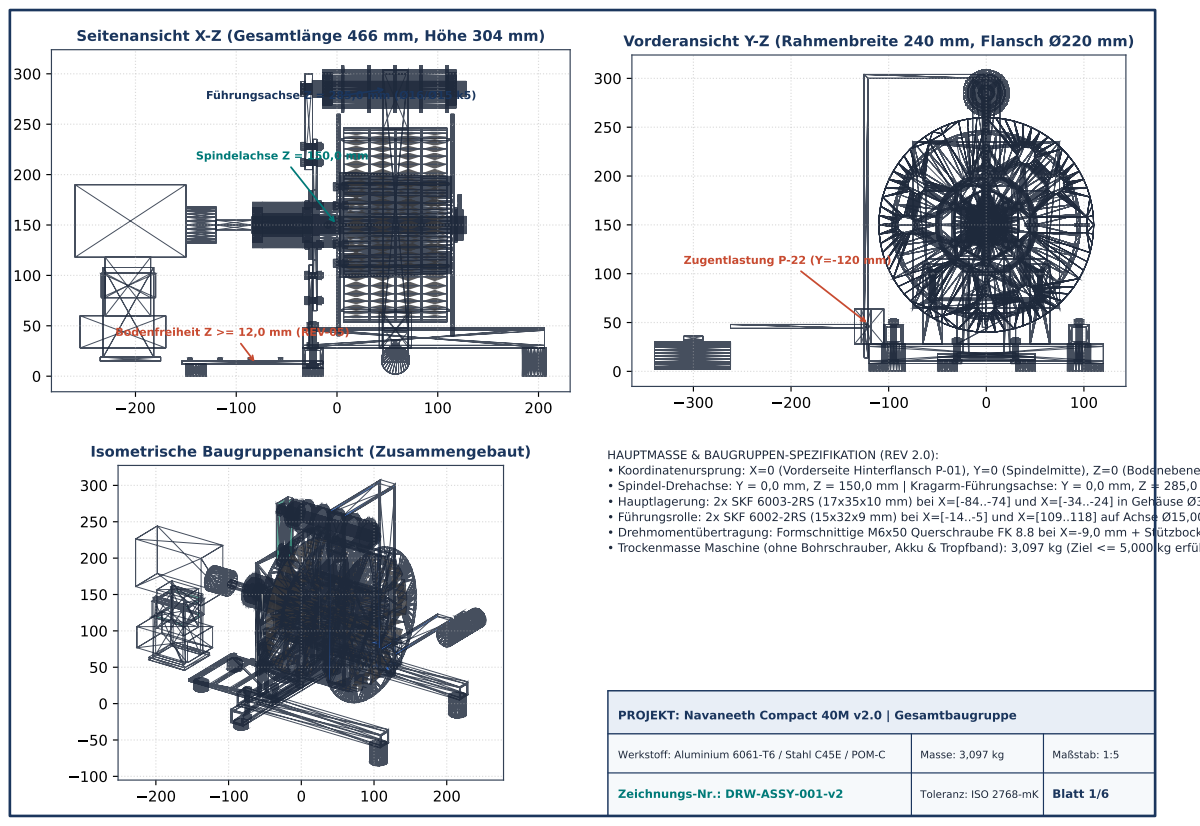
[picture p29: page 1]
Bodenfreiheit Z >=; 12,0 mm (REV-05); Zugentlastung P-22 (Y=-120 mm); Isometrische Baugruppenansicht (Zusammengebaut); HAUPTMASSE & BAUGRUPPEN-SPEZIFIKATION (REV 2.0):; Werkstoff: Aluminium 6061-T6 / Stahl C45E / POM-C; Masse: 3,097 kg; Maßstab: 1:5; Zeichnungs-Nr.: DRW-ASSY-001-v2; Toleranz: ISO 2768-mK; Blatt 1/6

Seitenansicht X-Z (Gesamtlänge 466 mm, Höhe 304 mm)

Vorderansicht Y-Z (Rahmenbreite 240 mm, Flansch Ø220 mm)

Führungsachse Z = 285,0 mm (Ø16/Ø15 k5)

Spindelachse Z = 150,0 mm

Koordinatenursprung: X=0 (Vorderseite Hinterflansch P-01), Y=0 (Spindelmitte), Z=0 (Bodenebene)
Spindel-Drehachse: Y = 0,0 mm, Z = 150,0 mm | Kragarm-Führungsachse: Y = 0,0 mm, Z = 285,0 mm
Hauptlagerung: 2x SKF 6003-2RS (17x35x10 mm) bei X=[-84..-74] und X=[-34..-24] in Gehäuse Ø35 H7
Führungsrolle: 2x SKF 6002-2RS (15x32x9 mm) bei X=[-14..-5] und X=[109..118] auf Achse Ø15,00 k5
Drehmomentübertragung: Formschnittige M6x50 Querschraube FK 8.8 bei X=-9,0 mm + Stützbock P-21
Trockenmasse Maschine (ohne Bohrschrauber, Akku & Tropfband): 3,097 kg (Ziel <= 5,000 kg erfüllt)

PROJEKT: Navaneeth Compact 40M v2.0 | Gesamtbaugruppe

300

400

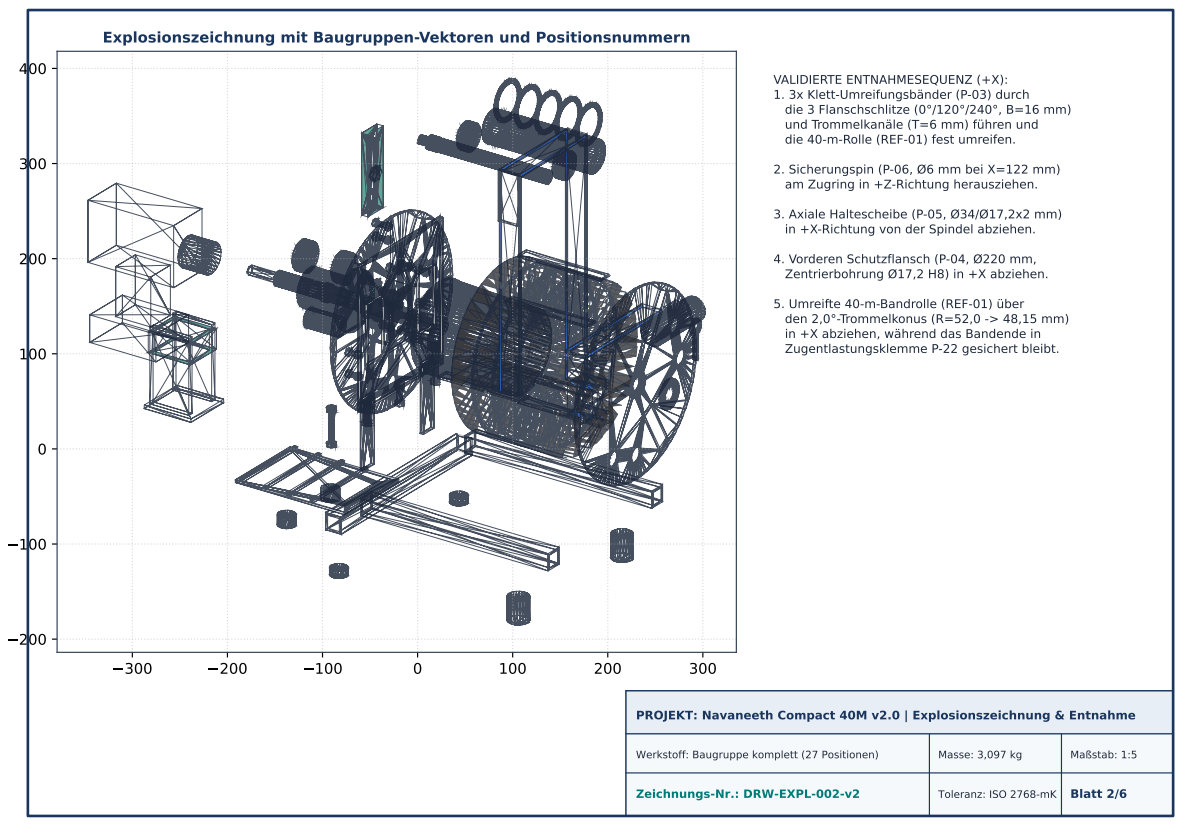
[picture p30: page 2]
Werkstoff: Baugruppe komplett (27 Positionen); Masse: 3,097 kg; Maßstab: 1:5; Zeichnungs-Nr.: DRW-EXPL-002-v2; Toleranz: ISO 2768-mK; Blatt 2/6

Explosionszeichnung mit Baugruppen-Vektoren und Positionsnummern

VALIDIERTE ENTNAHMESEQUENZ (+X):
1. 3x Klett-Umreifungsbänder (P-03) durch
die 3 Flanschschlitze (0°/120°/240°, B=16 mm)
und Trommelkanäle (T=6 mm) führen und
die 40-m-Rolle (REF-01) fest umreifen.

2. Sicherungspin (P-06, Ø6 mm bei X=122 mm)
am Zugring in +Z-Richtung herausziehen.

3. Axiale Haltescheibe (P-05, Ø34/Ø17,2x2 mm)
in +X-Richtung von der Spindel abziehen.

4. Vorderen Schutzflansch (P-04, Ø220 mm,
Zentrierbohrung Ø17,2 H8) in +X abziehen.

5. Umreifte 40-m-Bandrolle (REF-01) über
den 2,0°-Trommelkonus (R=52,0 -> 48,15 mm)
in +X abziehen, während das Bandende in
Zugentlastungsklemme P-22 gesichert bleibt.

PROJEKT: Navaneeth Compact 40M v2.0 | Explosionszeichnung & Entnahme

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

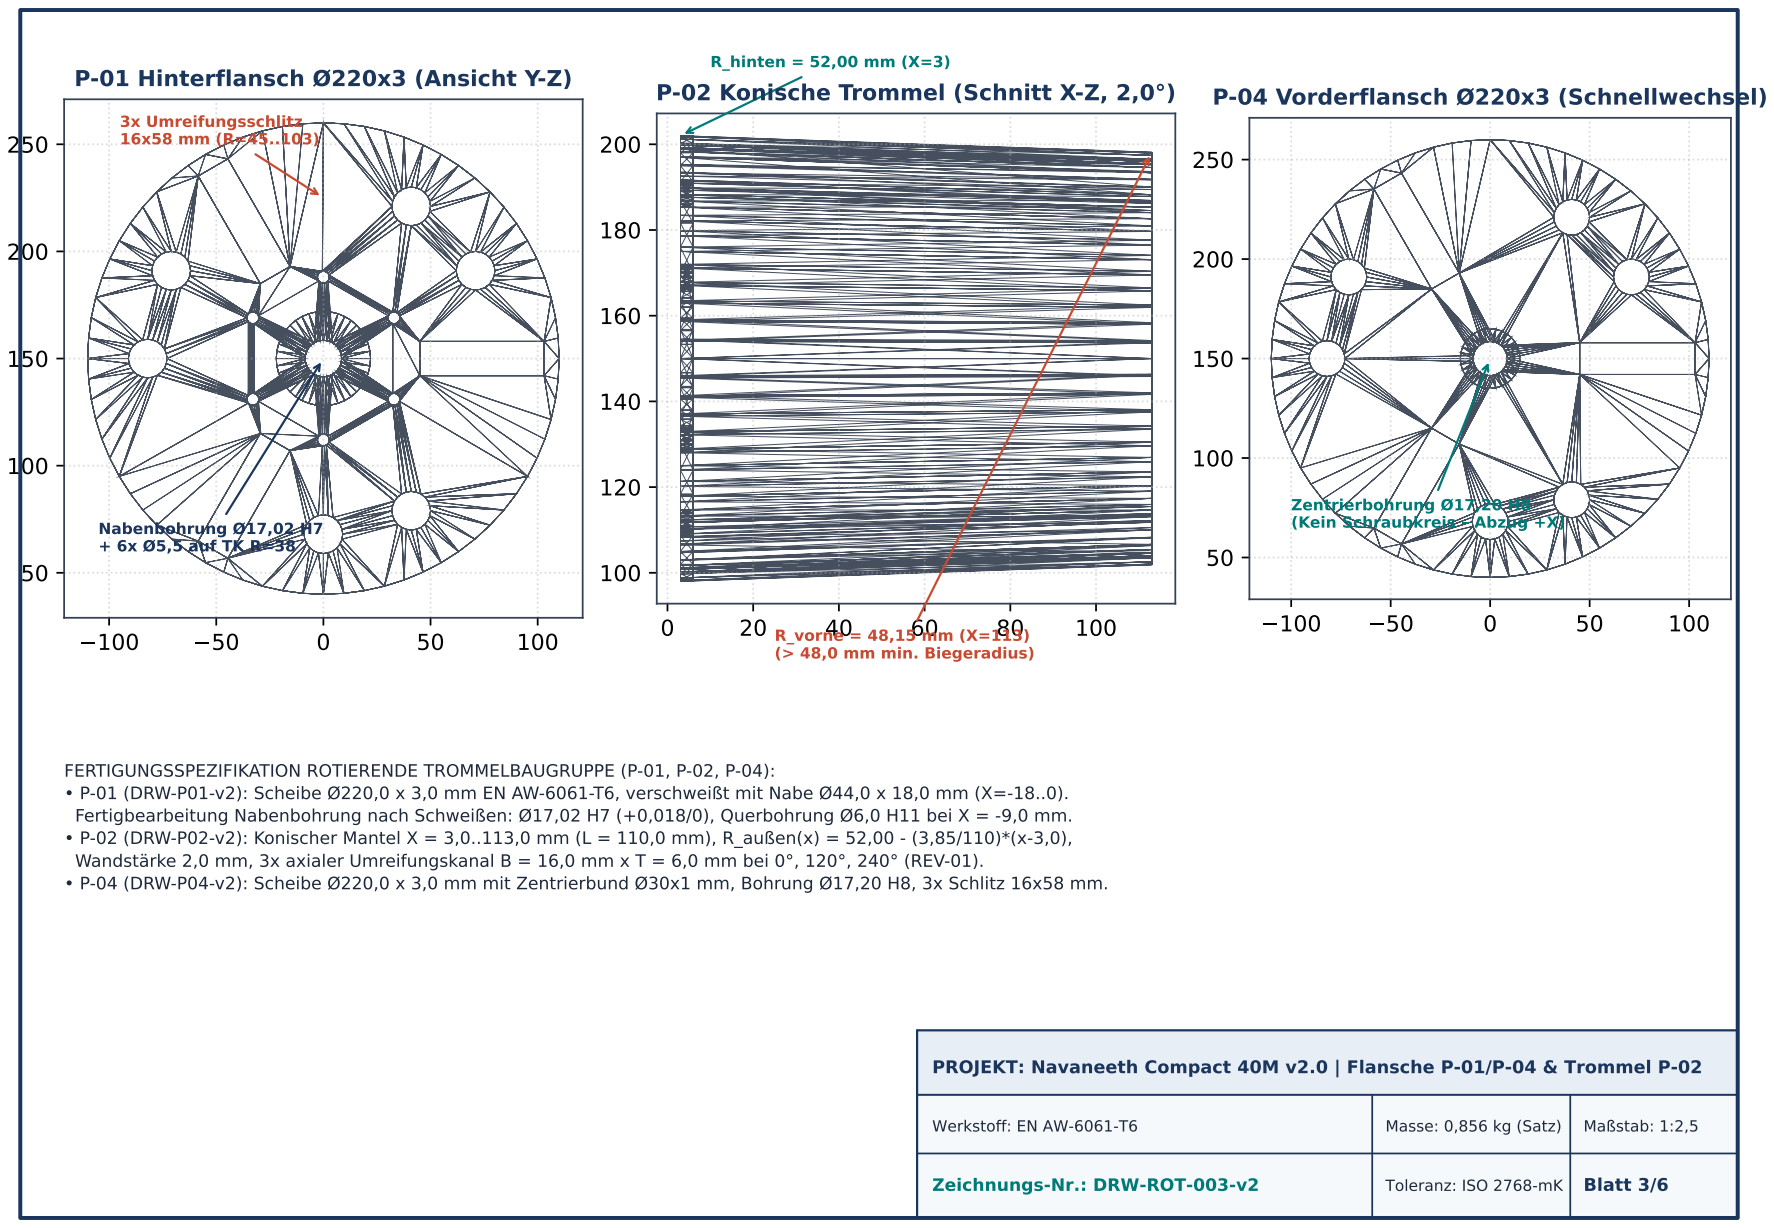
[picture p31: page 3]

### P-07 Hauptspindel Ø17,00 k5 mit Schulter Ø20 und 3/8"-Antriebszapfen (L_ges = 248 mm)

180

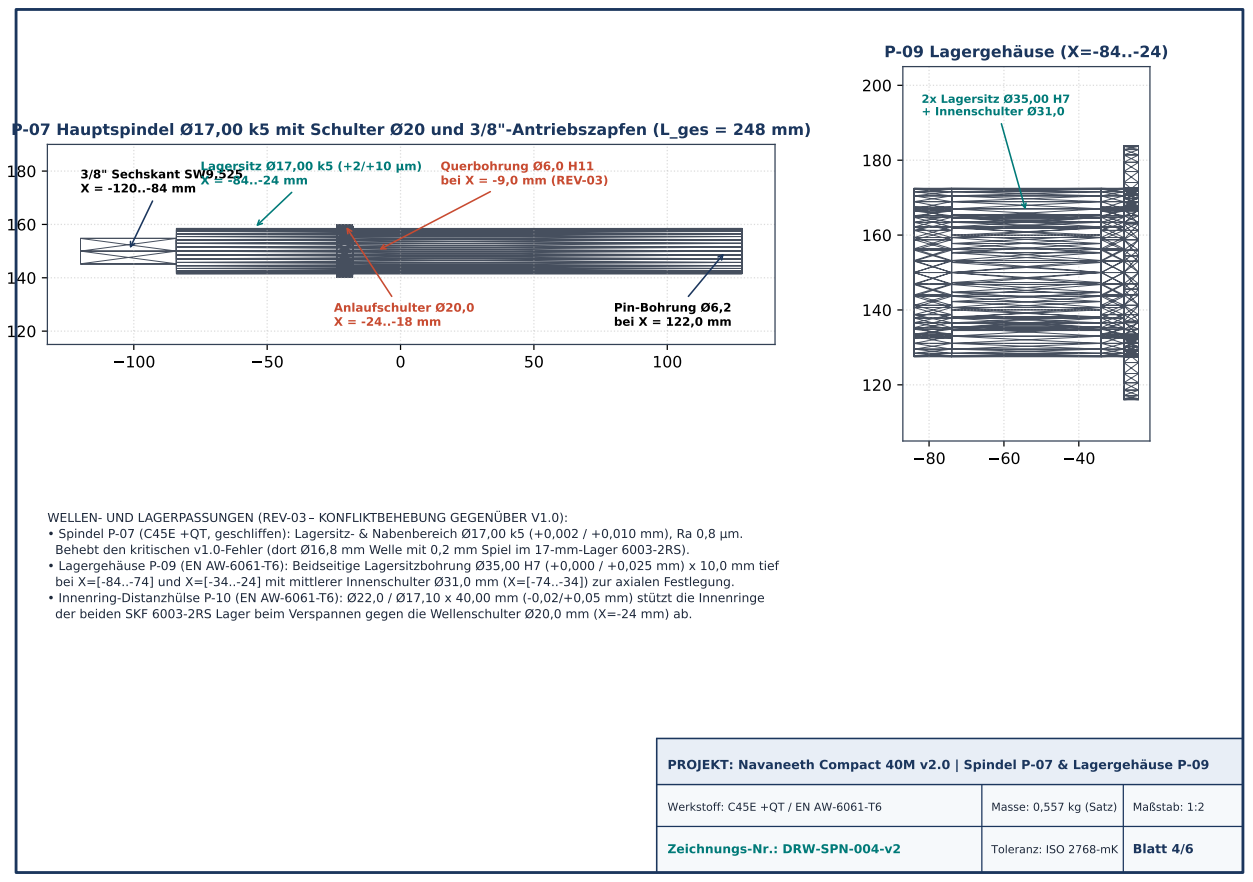
[picture p32: page 4]
3/8" Sechskant SW9,525; Anlaufschulter Ø20,0 X = -24..-18 mm; Pin-Bohrung Ø6,2 bei X = 122,0 mm; 2x Lagersitz; + Innenschulter Ø31,0; P-09 Lagergehäuse (X=-84..-24); Werkstoff: C45E +QT / EN AW-6061-T6; Masse: 0,557 kg (Satz); Maßstab: 1:2; Zeichnungs-Nr.: DRW-SPN-004-v2; Toleranz: ISO 2768-mK; Blatt 4/6

Lagersitz | Ø17,00 k5 (+2/+10 µm) | Querbohrung | Ø6,0 H11

X = -120..-84 mm | X = -84..-24 mm | | bei X = -9,0 mm (REV-03)

WELLEN- UND LAGERPASSUNGEN (REV-03 KONFLIKTBEHEBUNG GEGENÜBER V1.0):
Spindel P-07 (C45E +QT, geschliffen): Lagersitz- & Nabenbereich Ø17,00 k5 (+0,002 / +0,010 mm), Ra 0,8 µm.
Behebt den kritischen v1.0-Fehler (dort Ø16,8 mm Welle mit 0,2 mm Spiel im 17-mm-Lager 6003-2RS).
Lagergehäuse P-09 (EN AW-6061-T6): Beidseitige Lagersitzbohrung Ø35,00 H7 (+0,000 / +0,025 mm) x 10,0 mm tief
bei X=[-84..-74] und X=[-34..-24] mit mittlerer Innenschulter Ø31,0 mm (X=[-74..-34]) zur axialen Festlegung.
Innenring-Distanzhülse P-10 (EN AW-6061-T6): Ø22,0 / Ø17,10 x 40,00 mm (-0,02/+0,05 mm) stützt die Innenringe
der beiden SKF 6003-2RS Lager beim Verspannen gegen die Wellenschulter Ø20,0 mm (X=-24 mm) ab.

PROJEKT: Navaneeth Compact 40M v2.0 | Spindel P-07 & Lagergehäuse P-09

300

320

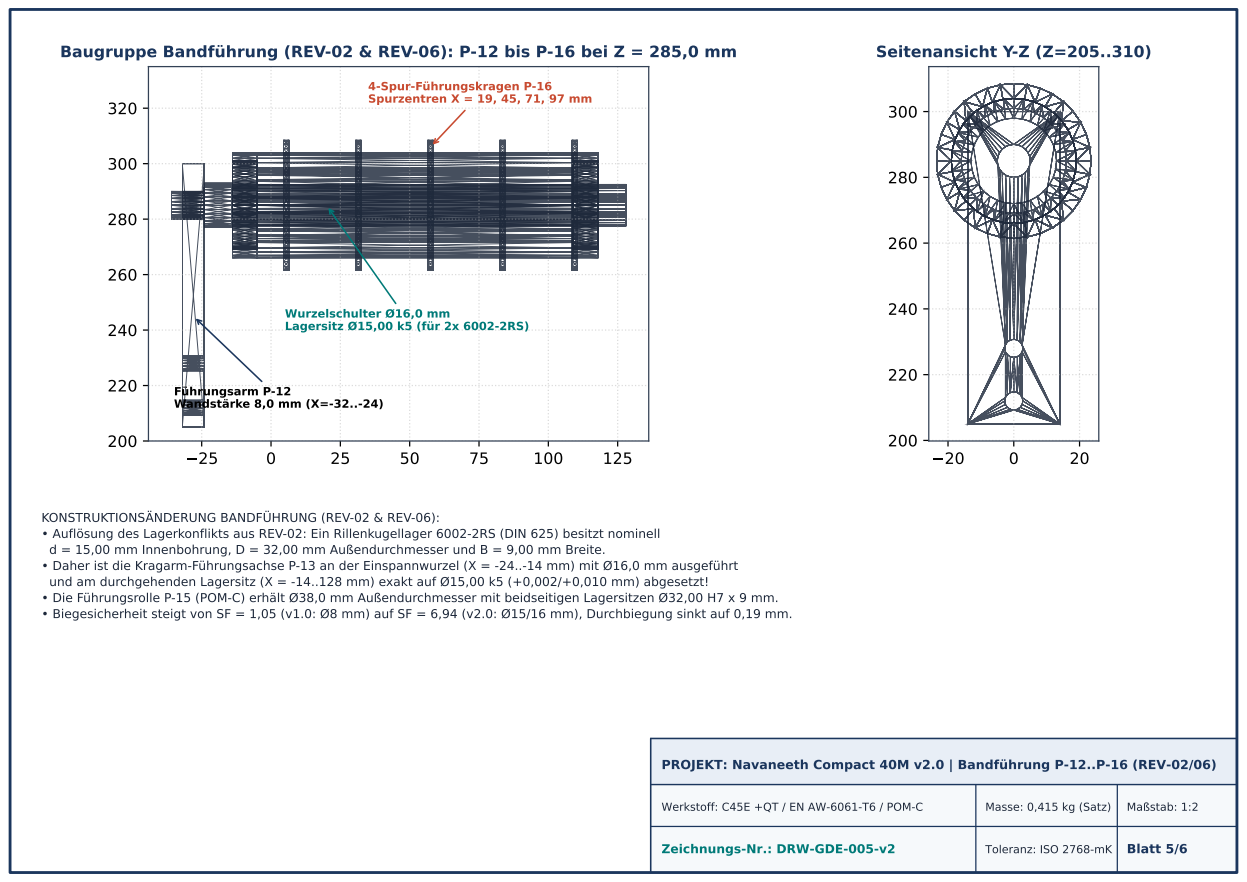
[picture p33: page 5]
Führungsarm P-12 Wandstärke 8,0 mm (X=-32..-24); Wurzelschulter Ø16,0 mm Lagersitz Ø15,00 k5 (für 2x 6002-2RS); 4-Spur-Führungskragen P-16; Spurzentren X = 19, 45, 71,; Seitenansicht Y-Z (Z=205..310); Werkstoff: C45E +QT / EN AW-6061-T6 / POM-C; Masse: 0,415 kg (Satz); Maßstab: 1:2; Zeichnungs-Nr.: DRW-GDE-005-v2; Toleranz: ISO 2768-mK; Blatt 5/6

Baugruppe Bandführung (REV-02 & REV-06): P-12 bis P-16 bei Z = 285,0 mm

KONSTRUKTIONSÄNDERUNG BANDFÜHRUNG (REV-02 & REV-06):
Auflösung des Lagerkonflikts aus REV-02: Ein Rillenkugellager 6002-2RS (DIN 625) besitzt nominell
d = 15,00 mm Innenbohrung, D = 32,00 mm Außendurchmesser und B = 9,00 mm Breite.
Daher ist die Kragarm-Führungsachse P-13 an der Einspannwurzel (X = -24..-14 mm) mit Ø16,0 mm ausgeführt
und am durchgehenden Lagersitz (X = -14..128 mm) exakt auf Ø15,00 k5 (+0,002/+0,010 mm) abgesetzt!
Die Führungsrolle P-15 (POM-C) erhält Ø38,0 mm Außendurchmesser mit beidseitigen Lagersitzen Ø32,00 H7 x 9 mm.
Biegesicherheit steigt von SF = 1,05 (v1.0: Ø8 mm) auf SF = 6,94 (v2.0: Ø15/16 mm), Durchbiegung sinkt auf 0,19 mm.

PROJEKT: Navaneeth Compact 40M v2.0 | Bandführung P-12..P-16 (REV-02/06)

150

200

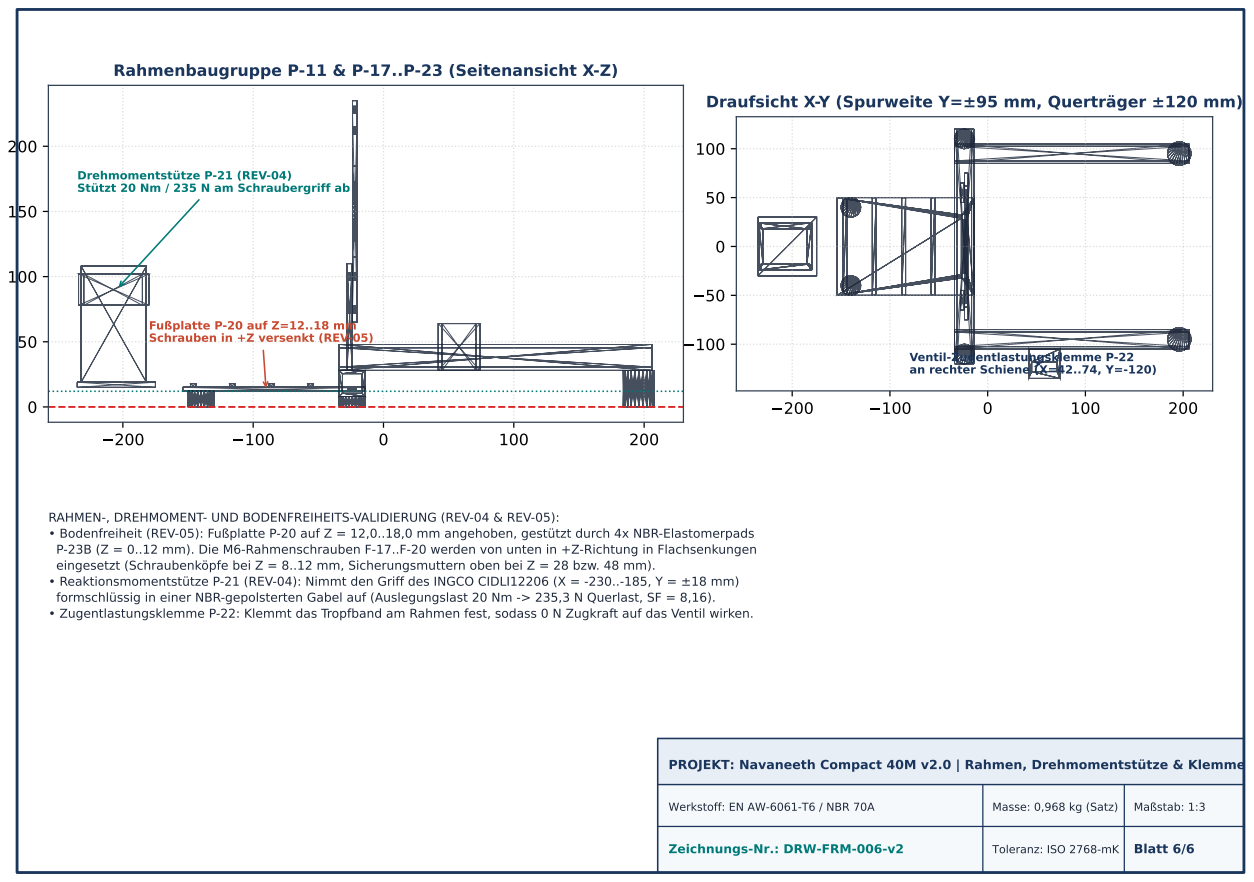
[picture p34: page 6]
Rahmenbaugruppe P-11 & P-17..P-23 (Seitenansicht X-Z); Werkstoff: EN AW-6061-T6 / NBR 70A; Masse: 0,968 kg (Satz); Maßstab: 1:3; Zeichnungs-Nr.: DRW-FRM-006-v2; Toleranz: ISO 2768-mK; Blatt 6/6

Draufsicht X-Y (Spurweite Y=±95 mm, Querträger ±120 mm)

Drehmomentstütze P-21 (REV-04)
Stützt 20 Nm / 235 N am Schraubergriff ab

Fußplatte P-20 auf Z=12..18 mm Schrauben in +Z | versenkt (REV-05)

Ventil-Zugentlastungsklemme P-22 an rechter Schiene (X=42..74, Y=-120)

RAHMEN-, DREHMOMENT- UND BODENFREIHEITS-VALIDIERUNG (REV-04 & REV-05):
Bodenfreiheit (REV-05): Fußplatte P-20 auf Z = 12,0..18,0 mm angehoben, gestützt durch 4x NBR-Elastomerpads
P-23B (Z = 0..12 mm). Die M6-Rahmenschrauben F-17..F-20 werden von unten in +Z-Richtung in Flachsenkungen
eingesetzt (Schraubenköpfe bei Z = 8..12 mm, Sicherungsmuttern oben bei Z = 28 bzw. 48 mm).
Reaktionsmomentstütze P-21 (REV-04): Nimmt den Griff des INGCO CIDLI12206 (X = -230..-185, Y = ±18 mm)
formschlüssig in einer NBR-gepolsterten Gabel auf (Auslegungslast 20 Nm -> 235,3 N Querlast, SF = 8,16).
Zugentlastungsklemme P-22: Klemmt das Tropfband am Rahmen fest, sodass 0 N Zugkraft auf das Ventil wirken.

PROJEKT: Navaneeth Compact 40M v2.0 | Rahmen, Drehmomentstütze & Klemme
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
